LeonardoSerafin/Smartdesk-code/(commit log)

2026-03-30 fix errore starting time
    [mix.ino]
2026-03-31 modifica modalità prenotazione e bug-fix
    [mix.ino]
2026-03-31 fix cancellazione pren. per assenza
    [mix.ino]
2026-05-28 fix timer check-in
2026-06-08 purple screen conflict fix
    [TableFunctions.cpp]
